el-nikitos/ITR-1/ITR-1/PNG/ITR-1-B.png

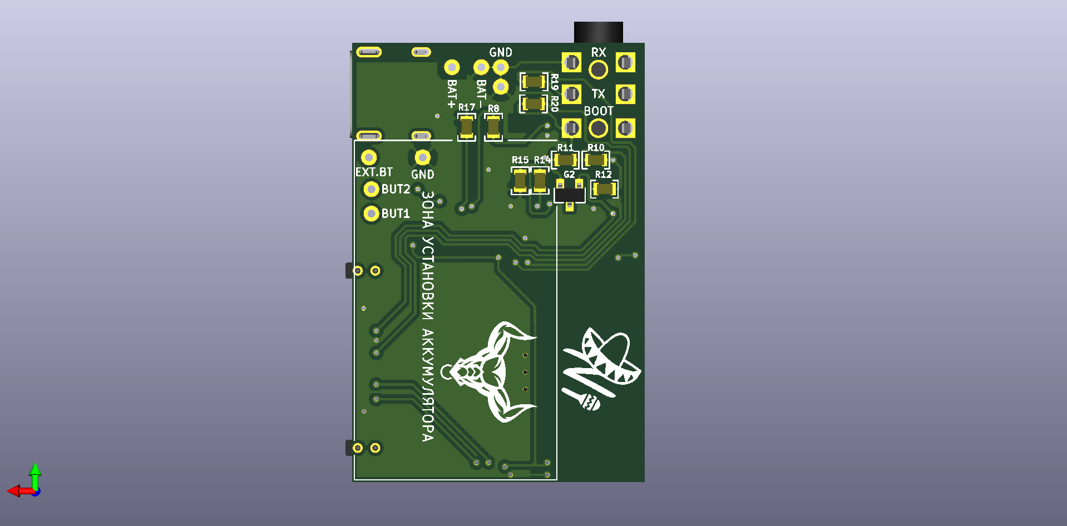
ITR-1/PNG/ITR-1-B.png
