el-nikitos/ITR-1/ITR-1/PDF/заказ.xlsx

 |  |  |  |  | нужно | есть
> C1, C2 | Конденсатор_керамический | N_RLC:Конденсатор_SMD_IEC_0805 | 10 мкФ/25 В |  | 2 | 6
> C3-C5 | Конденсатор_керамический | N_RLC:Конденсатор_SMD_0603_pnp | 10 мкФ/6,3 В |  | 3 | 1 | донор
DA1 | ОУ_LMV321ILT | N_G:SOT-23-5_pnp |  |  | 1 |  |  | чип
DD1 | Микросхема_заряда_MCP73831T-2ACI_OT | N_G:SOT-23-5_pnp |  |  | 1 | 1
FU1 | Предохранитель_MF-MSMF030 | N_RLC:Предохранитель_SMD_1812 | 0,3 А | https://www.chipdip.ru/product/mf-msmf030 | 1 |  | перемычка
G2 | ИОП_LM4040BIM3-2.5_NOPB | N_VD_HL:Транзистор_IRLML6344TR_SOT-23 | - | https://www.chipdip.ru/product/lm4040bim3-2.5-nopb | 1 |  | донор
HL2 | Светодиод_сдвоенный_KPB-3025SURKCGKC | N_VD_HL:Светодиод_SMD_m3025 |  |  | 1 | 12
> K1, K2 | Кнопка_KLS7-TS5401-1.35-250-T | N_X:Кнопка_KLS7-TS5401 |  |  | 2 | 1
> R1, R7, R13 | Резистор_0,065Вт | N_RLC:Резистор_SMD_0603_0,065_Вт | 4,7 кОм |  | 3 |  | донор
> R2, R6, R10-R12, R14, R18, R26 | Резистор_0,065Вт | N_RLC:Резистор_SMD_0603_0,065_Вт | 10 кОм |  | 8 | 7
> R3-R5, R8, R16, R17, R25 | Резистор_0,065Вт | N_RLC:Резистор_SMD_0603_0,065_Вт | 240 Ом |  | 7 | 5
R15 | Резистор_0,065Вт | N_RLC:Резистор_SMD_0603_0,065_Вт | 30 кОм |  | 1 | 16
> R9, R19, R20 | Резистор_0,065Вт | N_RLC:Резистор_SMD_0603_0,065_Вт | 100 Ом |  | 3 |  | донор
VD1 | Диоды_шоттки_BAR43CFILM | N_VD_HL:Транзистор_IRLML6344TR_SOT-23 |  |  | 1 |  | донор
VD5 | Стабилитрон_BZV55-C3V9 | N_VD_HL:SOD-80 | 3,9 В | https://www.chipdip.ru/product/bzv55-c3v9.115 | 1 |  |  | чип
> VT1-VT4 | ... | N_VD_HL:Транзистор_IRLML6344TR_SOT-23 | P-канал |  | 3 | 1
 |  |  | N-канал |  | 1 | 11
XS1 | Клеммник_х3 | N_X:jack_ST-033 |  | https://www.chipdip.ru/product/st-033 | 1 |  | донор
XS3 | UBS-type-C-105450-0101&упрощенная | N_X:usb-type-c |  | https://www.chipdip.ru/product/105450-0101-molex | 1 |  |  | чип
