el-nikitos/ITR-1/ITR-1/PDF/ITR-1-1.pdf

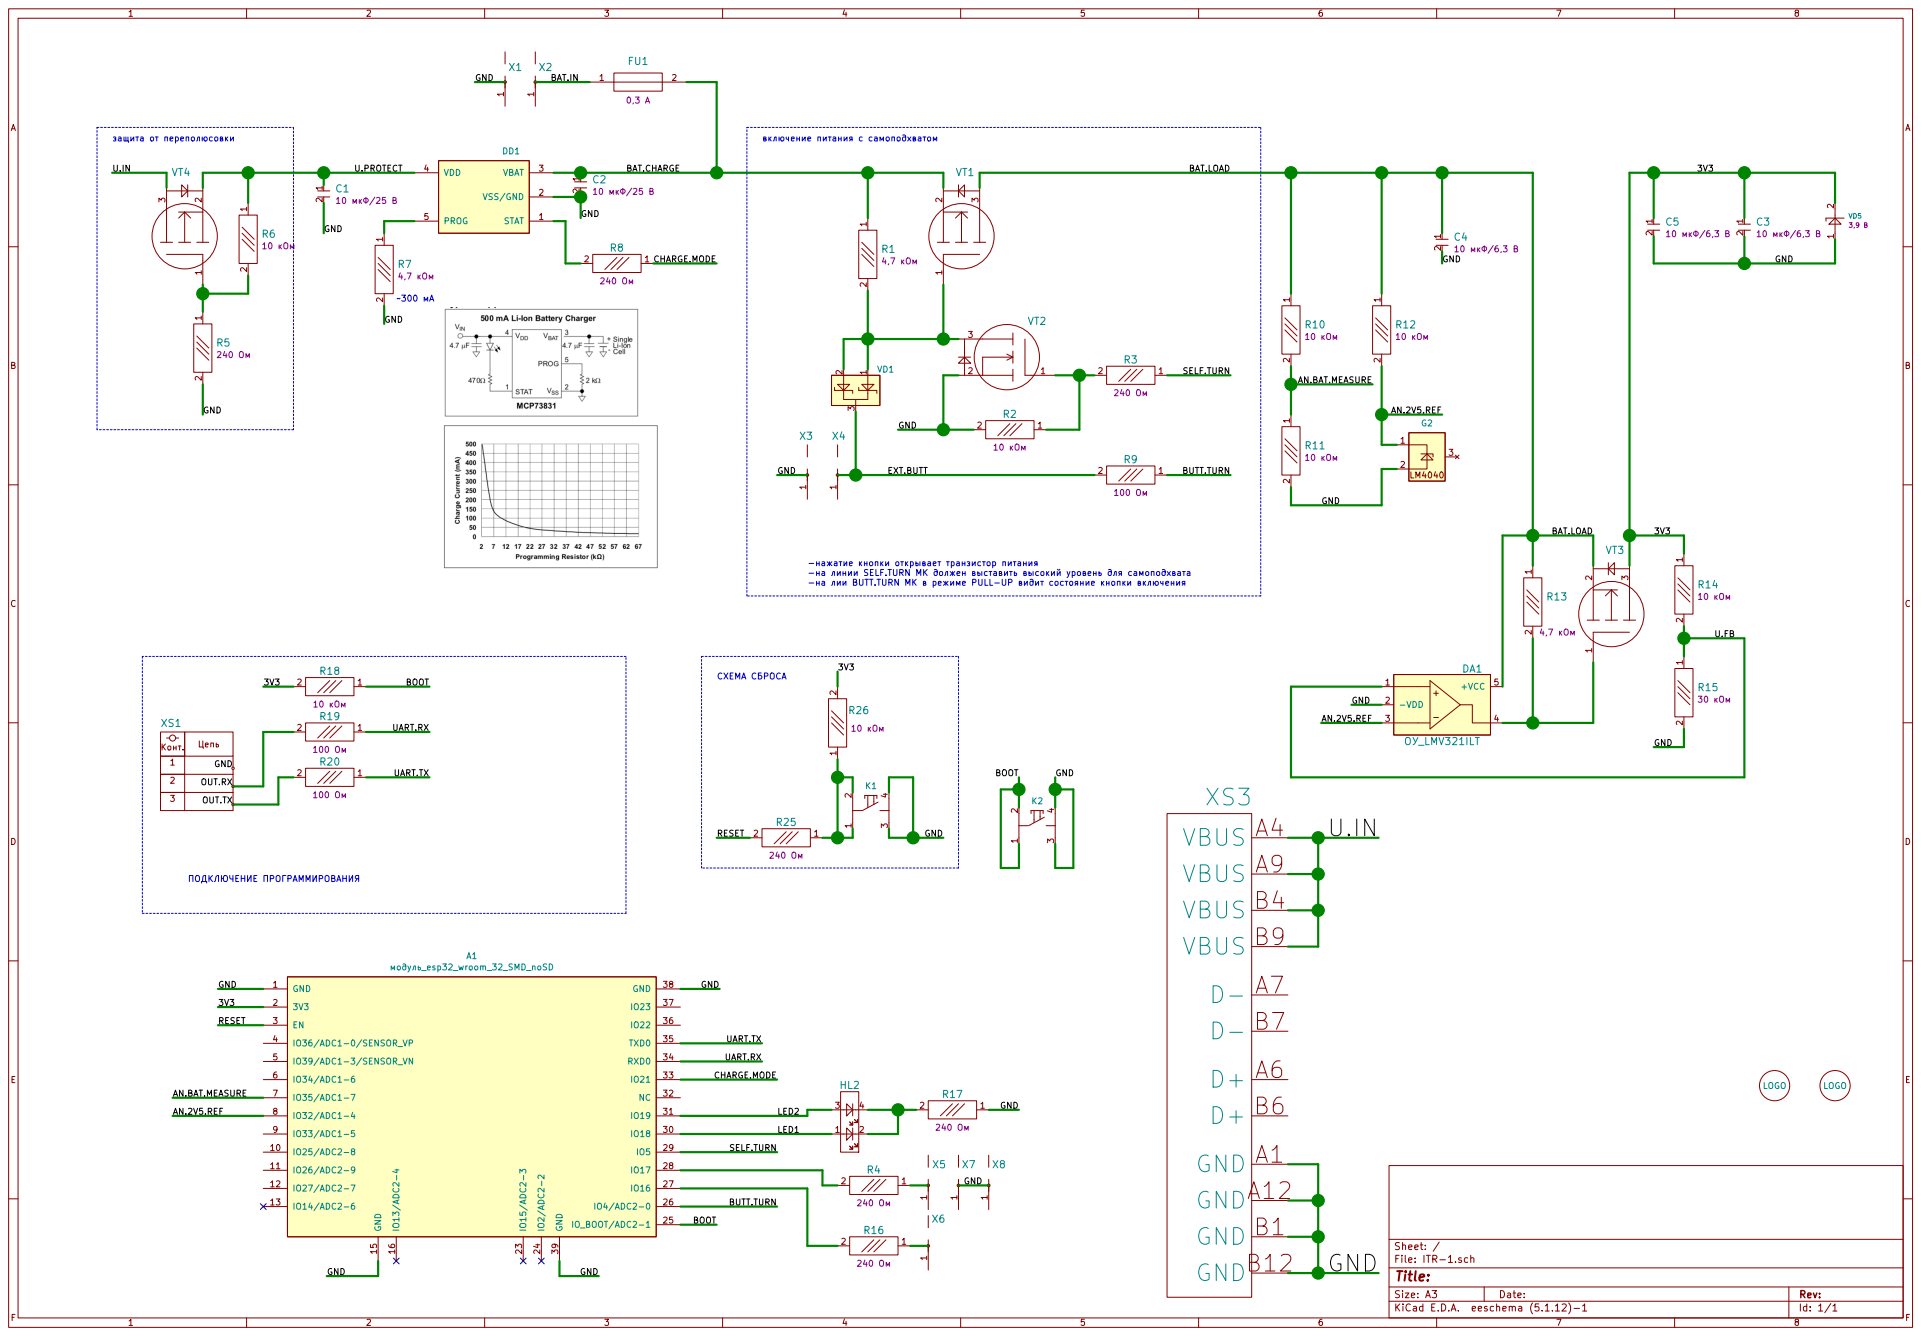
[picture p3: page 1]

3,9 3V3 UART.RX UART.TX

SELF.TURN OUT.RX

- - SELF.TURN - BUTT.TURN PULL-UP

AN.2V5.REF SELF.TURN

Id: 1/1 Title: File: ITR-1.sch Sheet: /
