el-nikitos/ITR-1/ITR-1/PDF/ITR-1-0.pdf

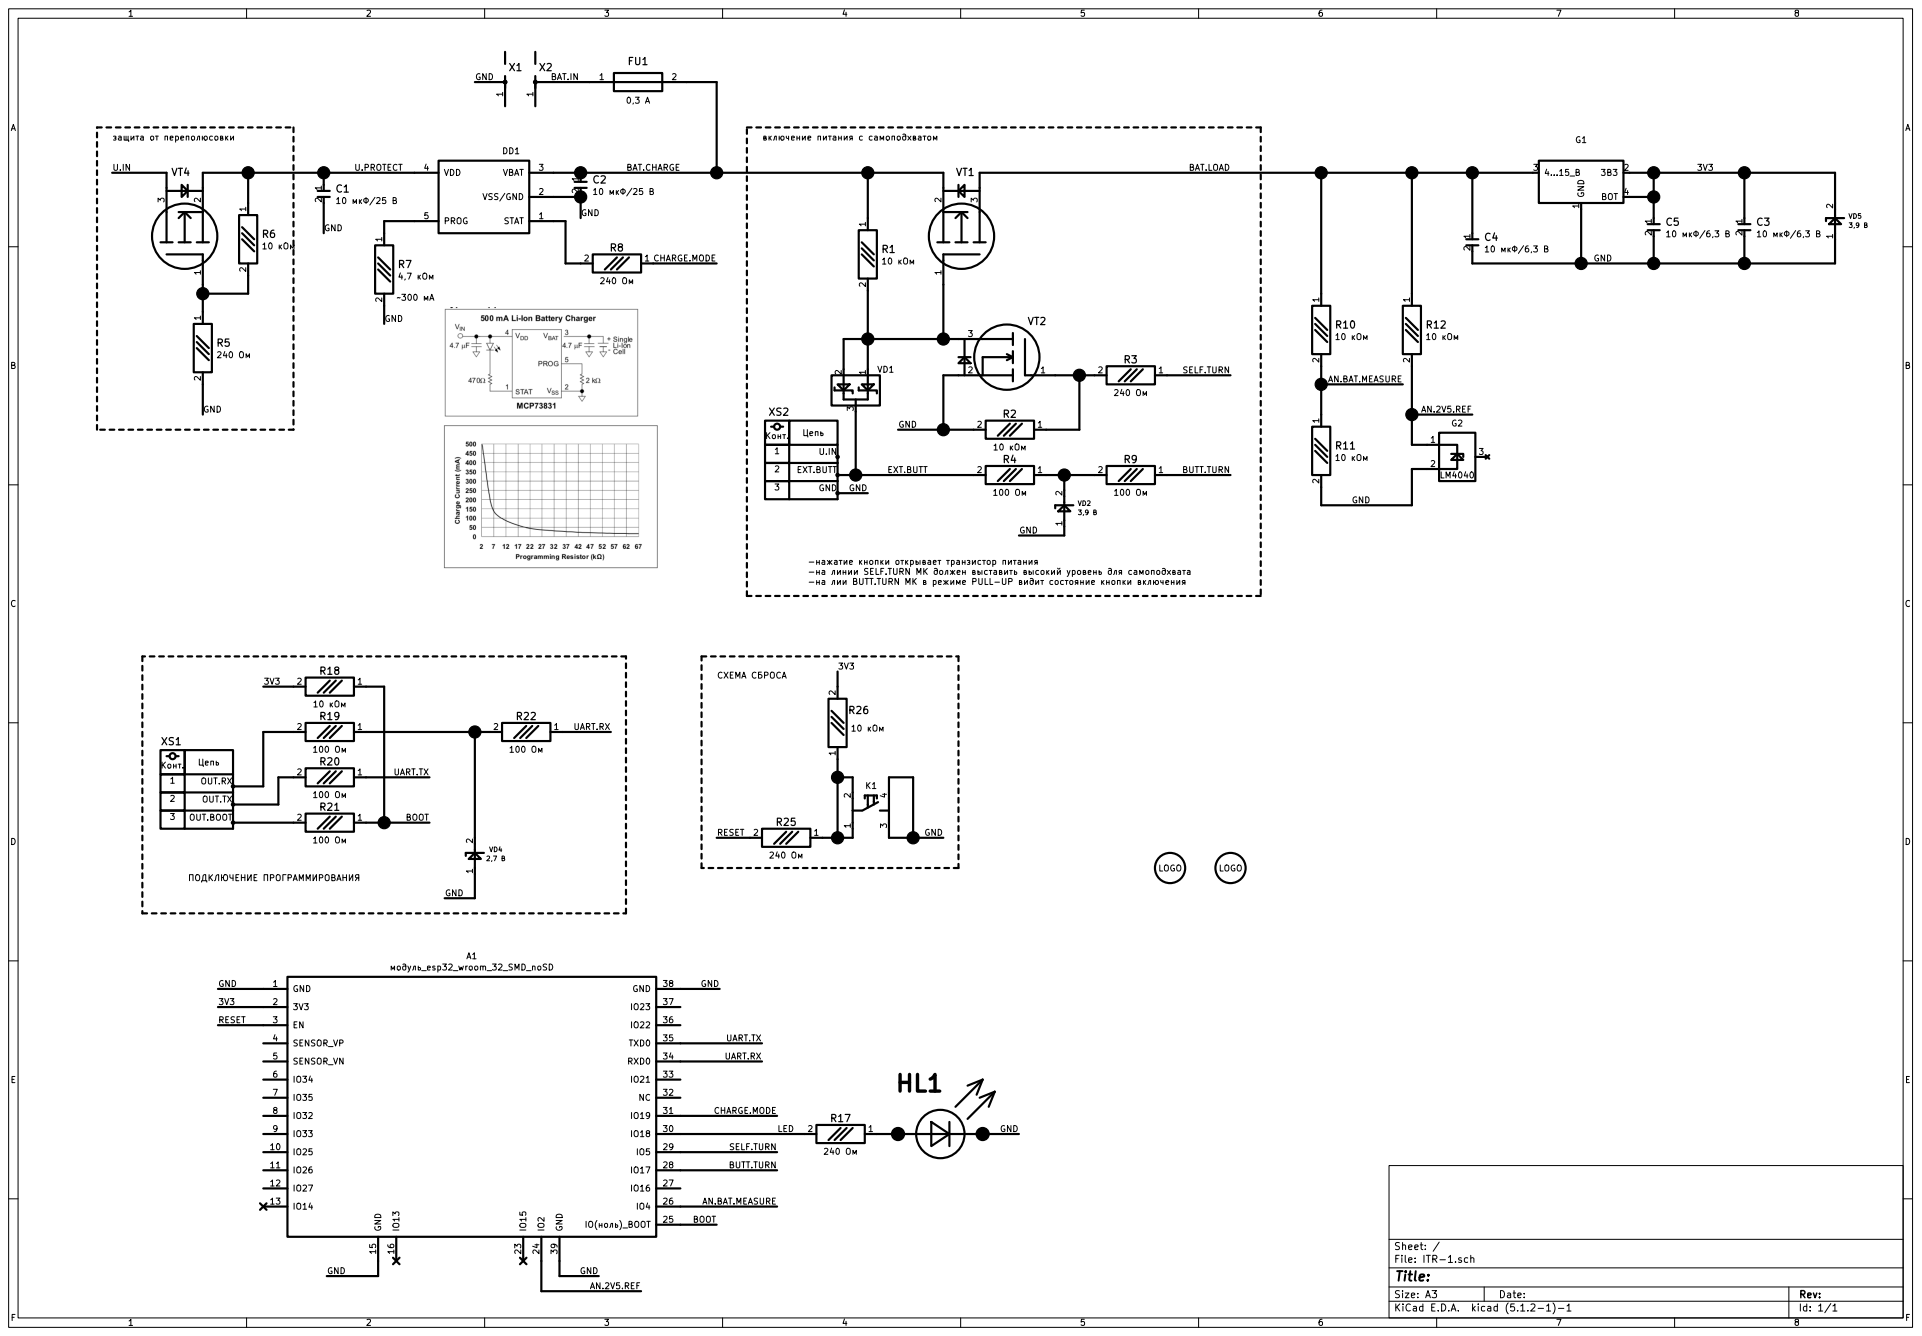
[picture p4: page 1]

- - SELF.TURN - BUTT.TURN PULL-UP

Id: 1/1 Title: File: ITR-1.sch Sheet: / GND 1
