el-nikitos/ITR-1/arduino-ITR-1-2/WIFI_functions.ino

String s_wifi_IP_status = "connect is lost";
unsigned long ulong_IP = 0;

void check_connect()  {
  //
  if ((WiFi.status() != WL_CONNECTED))  {
    s_wifi_IP_status = "connection is lost";
    b_CONNECT = false;
  } else {
    ulong_IP = WiFi.localIP();
    s_wifi_IP_status = "" + String( (ulong_IP&0x000000ff) >> 0 ) +   
                      "." + String( (ulong_IP&0x0000ff00) >> 8) +
                      "." + String( (ulong_IP&0x00ff0000) >> 16) +
                      "." + String( (ulong_IP&0xff000000) >> 24);
    b_CONNECT = true;
  }
  //
}

void wifi_wireless_disconnect() {
  WiFi.disconnect();
  delay(100);
  check_connect();
}

void wifi_wireless_connect() {
  //
  byte byte_counter = 0;

  if ( b_CONNECT == false )  {
    WiFi.begin(ssid, password);

    while (WiFi.status() != WL_CONNECTED) {
      digitalWrite( LED_GREEN, LOW );
      
      digitalWrite( LED_RED, HIGH );
      delay(100);
      digitalWrite( LED_RED, LOW );
      delay(400);
      Serial.print(".");
      
      byte_counter++;
      
      if ( byte_counter >= 20 ) {
        WiFi.disconnect();
        break;
      }
    }
    digitalWrite( LED_RED, LOW );
  }

  b_CONNECT == true;
  check_connect();
  //
}

void send_motor_start() {
  client.connect( host, httpPort );
  delay(250);
  digitalWrite( LED_RED, HIGH );
  client.println("start");  //prinln
  delay(500);
  client.stop();
  digitalWrite( LED_RED, LOW );

  b_command_to_start = false;
  
  Serial.println("the START command has been sent");
  Serial.println();
}

void send_motor_stop()  {
  client.connect( host, httpPort );
  delay(250);
  digitalWrite( LED_RED, HIGH );
  client.println("stop"); //println
  delay(500);
  client.stop();
  digitalWrite( LED_RED, LOW );

  b_command_to_start = true;
  
  Serial.println("the STOP command has been sent");
  Serial.println();
}

void send_motor_up()  {
  client.connect( host, httpPort );
  delay(250);
  digitalWrite( LED_RED, HIGH );
  client.println("up"); //println
  delay(500);
  client.stop();
  digitalWrite( LED_RED, LOW );
  
  Serial.println("the UP command has been sent");
  Serial.println();
}

void send_motor_down()  {
  client.connect( host, httpPort );
  delay(250);
  digitalWrite( LED_RED, HIGH );
  client.println("down"); //println
  delay(500);
  client.stop();
  digitalWrite( LED_RED, LOW );
  
  Serial.println("the DOWN command has been sent");
  Serial.println();
}

void send_motor_ping()  {
  client.connect( host, httpPort );
  delay(250);
  client.println("PING");
  delay(500);
  client.stop();
}
