el-nikitos/ITR-1/(commit log)

2021-09-04 габаритная заготовка
    [ITR-1.kicad_pcb, ITR-1.sch]
2021-09-05 схема организации питания
    [ITR-1.kicad_pcb, ITR-1.sch]
2021-09-11 закончена схема, начата трассировка питания
    [ITR-1.kicad_pcb, ITR-1.sch]
2021-09-12 подготовлена трассировка питания, упрощена схема подключения периферии
    [ITR-1.kicad_pcb, ITR-1.sch]
2021-09-19 обновлены посадочные места и схема питания
    [ITR-1.kicad_pcb, ITR-1.sch]
2021-09-19 подготовлена трассировка +PNG +STP, требуется контрольная проверка
    [ITR-1.kicad_pcb, ITR-1.sch]
2021-09-19 причесана трассировка +PDF +GBR
    [ITR-1.kicad_pcb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]
2021-10-10 заготовка ПО под тестовый функционал
2021-10-16 добавлена кнопка воот, перенесен Ain, начато BT arduino
    [ITR-1.kicad_pcb, ITR-1.sch]
2021-10-16 заменен LDO на самопальный, уменьшена заливки, убраны дорожки под PCB
    [ITR-1.kicad_pcb]
2021-10-16 ARD: добавлено отключение при 120 сек отсутствия нажатия на кнопку
2021-10-16 добавлен терминал
2021-10-17 добавлены функции клиента WI-FI в терминал: wstatus, disconnect, connect
2021-10-17 аналоговые каналы перенесены на ADC1
    [ITR-1.kicad_pcb, ITR-1.sch]
2021-10-17 время выключения - 300 сек (5мин)
2021-10-17 пере определены аналоговые входа (вход aref не проверен)
2021-10-18 функция АЦП ардуино заменена на функцию ЕСП
2021-10-20 добавлена отправка START/STOP серверу при нажатии кнопки
2021-10-24 изменено опорное + подключение к мотору; заготовка под 2 светодиода
    [ITR-1.kicad_pcb, ITR-1.sch]
2021-10-24 модифицирована тайминги обмена с сервером, LED заменен на 2хцветный
    [ITR-1.kicad_pcb, ITR-1.sch]
2021-10-27 посылает команду start/stop с переносом картеки
2021-11-28 зарядка через USB, в сервисный джек добавлена земля, кнопка впаивается
    [ITR-1.kicad_pcb, ITR-1.sch]
2021-11-30 ITR-1-1NN(45x30): +2 отв. под внеш. кнопки, -избыт. защита входов
    [ITR-1.kicad_pcb, ITR-1.sch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]
2021-11-30 экспорт схемы PDF
    [ITR-1.sch]
2021-12-19 переопределены пины под новую плату, +доп.кнопки и LED +тестовый сервер
    [заказ.xlsx]
2021-12-19 параметры wifi для мотора, исправлен пин для статуса зарядки
    [WIFI_functions.ino, arduino-ITR-1-2.ino]
